davidpalma666/OE-PyBoard-Fork/_aux/pyboard-master from github/images/PYBv10b-photo-back.jpg

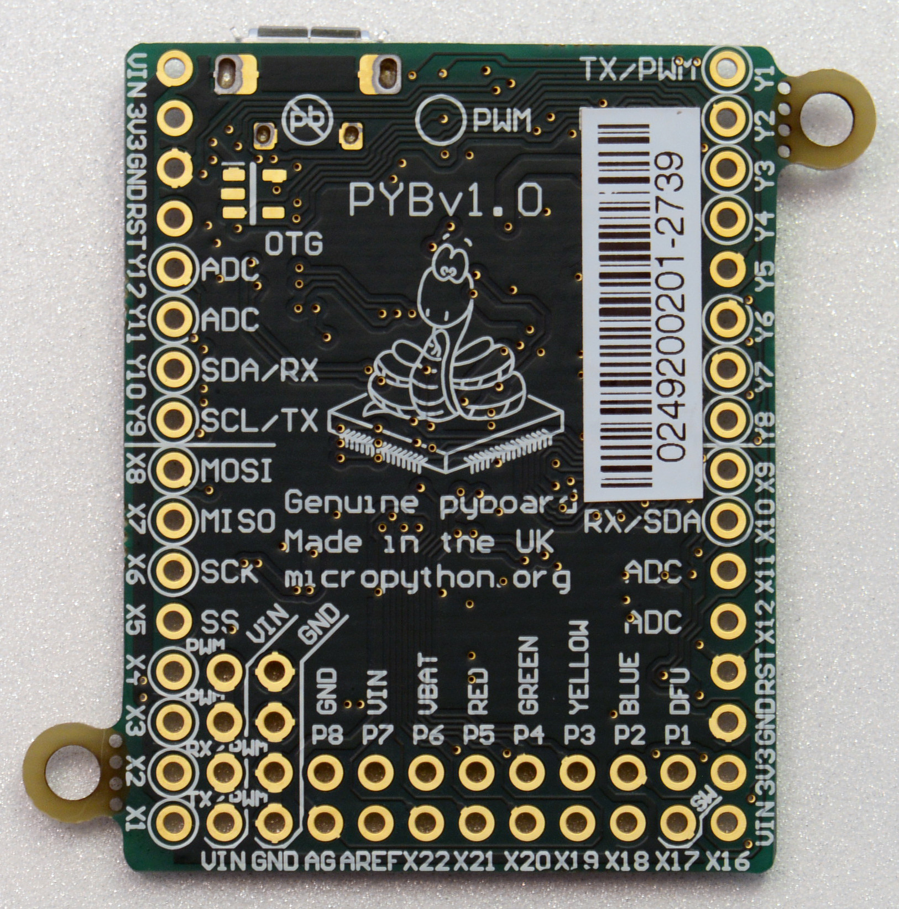
_aux/pyboard-master from github/images/PYBv10b-photo-back.jpg
