davidpalma666/OE-PyBoard-Fork/_aux/pyboard-master from github/images/PYBv10b-photo-front.jpg

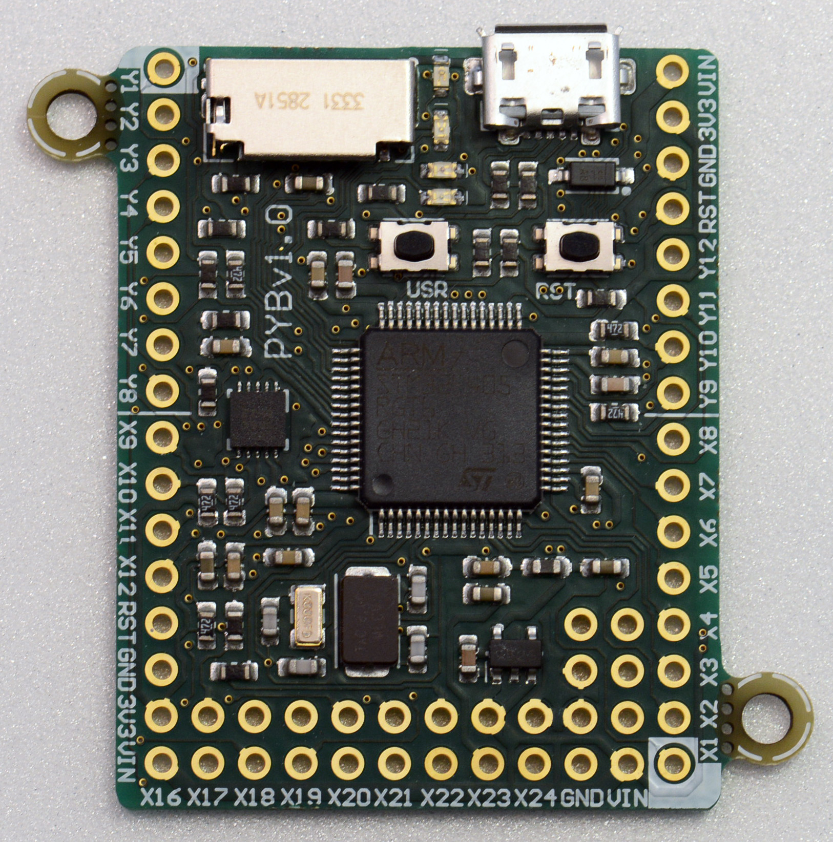
_aux/pyboard-master from github/images/PYBv10b-photo-front.jpg
