davidpalma666/OE-PyBoard-Fork/_aux/pyboard-master from github/images/PYBv10b-render-front.png

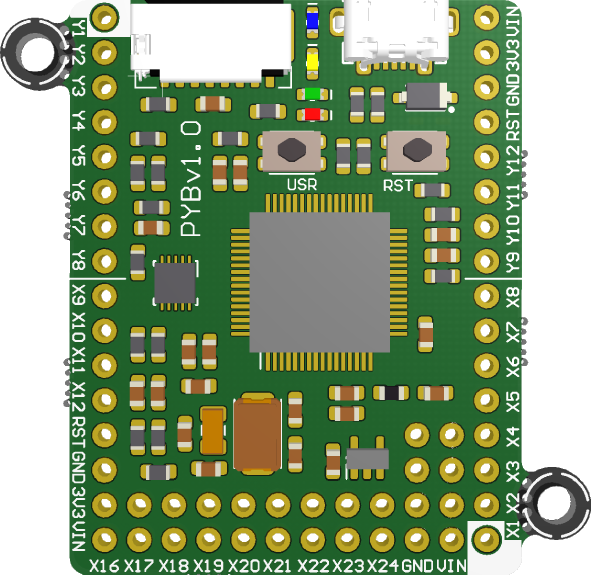
_aux/pyboard-master from github/images/PYBv10b-render-front.png
