davidpalma666/OE-PyBoard-Fork/_aux/pyboard-master from github/pinout/pybv3/pinout.png

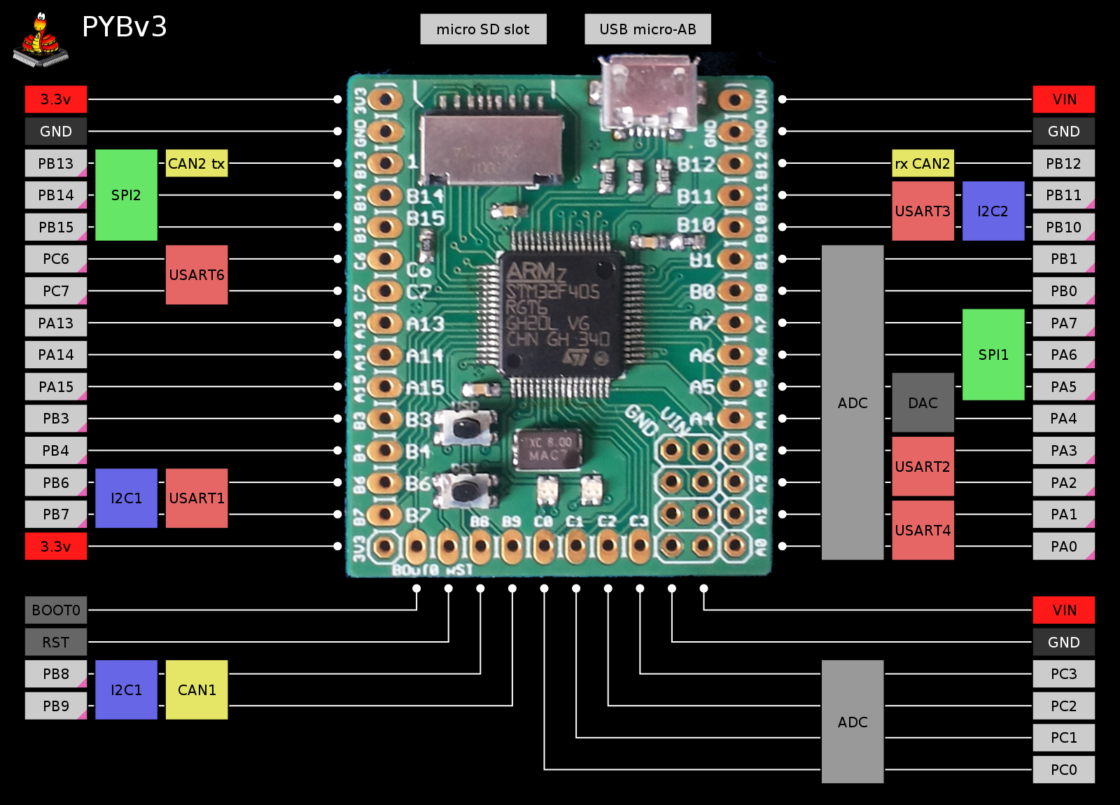
_aux/pyboard-master from github/pinout/pybv3/pinout.png
