davidpalma666/OE-PyBoard-Fork/_aux/pyboard-master from github/pinout/pybv3/pybv3.png

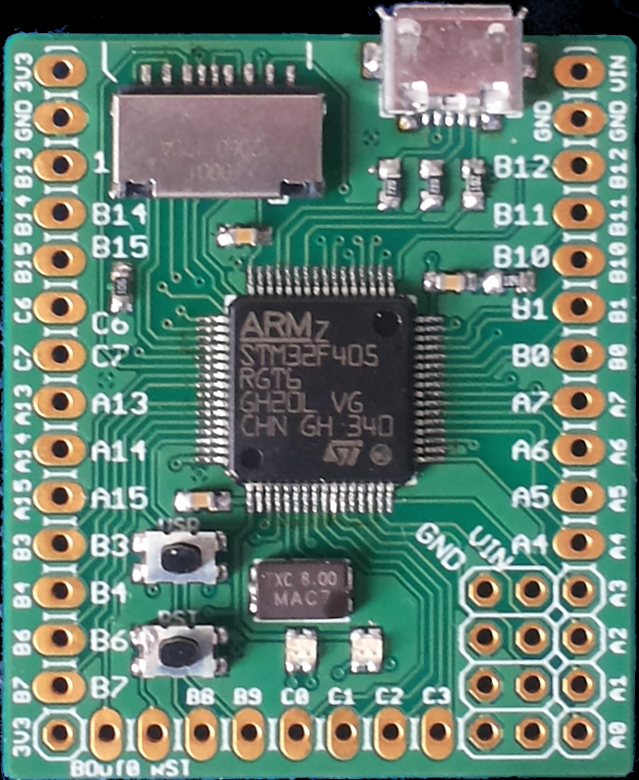
_aux/pyboard-master from github/pinout/pybv3/pybv3.png
