davidpalma666/OE-PyBoard-Fork/_aux/pyboard-master from github/pinout/pybv10b/pinout.png

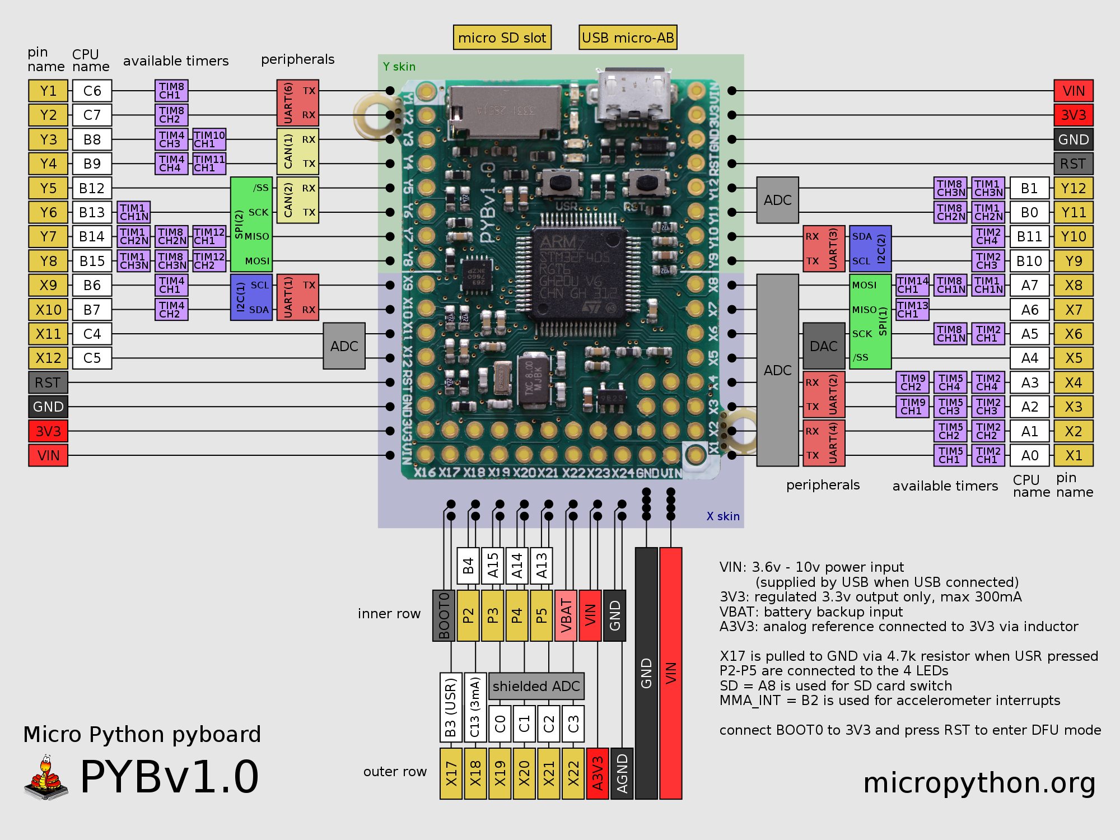
_aux/pyboard-master from github/pinout/pybv10b/pinout.png
