davidpalma666/OE-PyBoard-Fork/_aux/pyboard-master from github/schem.png

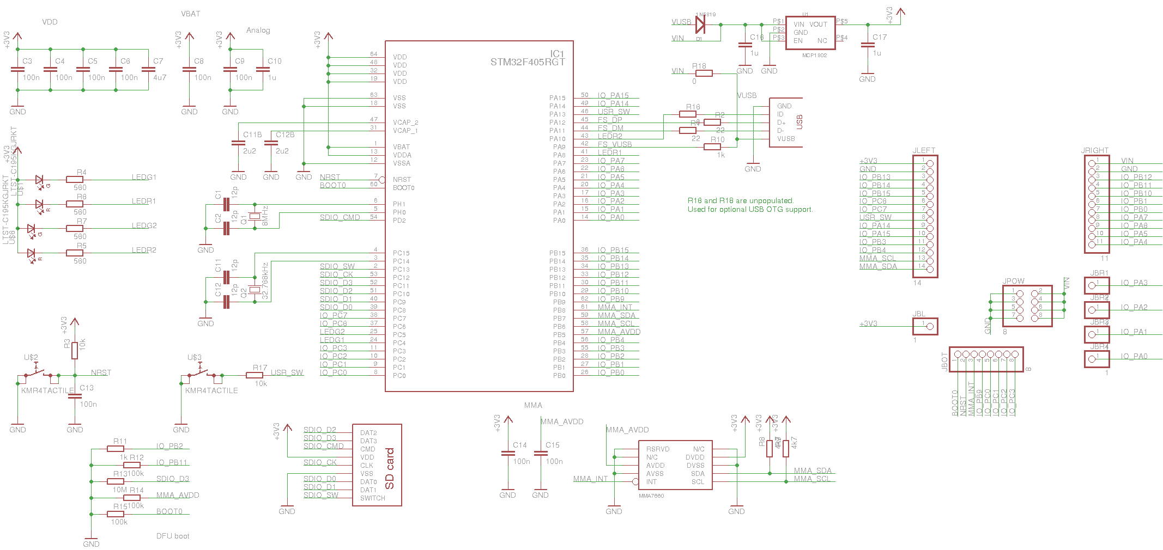
_aux/pyboard-master from github/schem.png
