davidpalma666/OE-PyBoard-Fork/PyBoardTester/pcb/production/PyBoardTester BOM.csv

# | Reference | Qty | Value | Footprint | DNP | MPN | OEPSPN
1 | J1,J2 | 2 | Conn_01x08 | Connector_PinHeader_2.54mm:PinHeader_1x16_P2.54mm_Vertical |  | TSW-116-06-T-S | OEPS070109
2 | ~{RST}#1,~{RST}#2 | 2 | SW_SPST | SWITCH TACTILE SPST-NO 0.05A 12V |  | TL3305BF260QG | OEPS100061
