davidpalma666/OE-PyBoard-Fork/PyBoardTester/pcb/PyBoardTester FootprintLib/SW_SPST_TL3305B.step

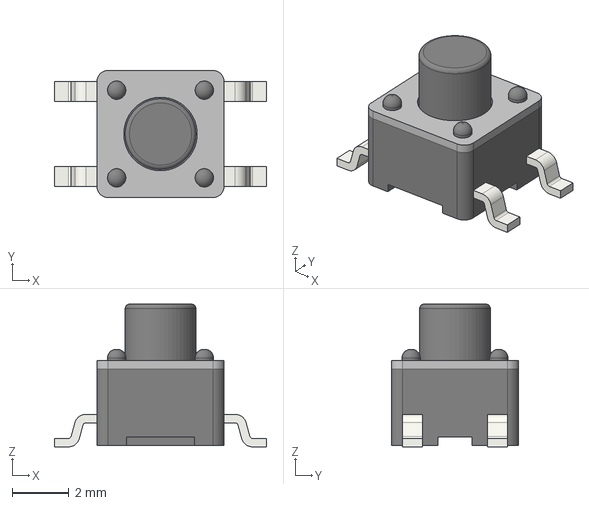
[picture p9: CAD file, 2025-12-09]
PyBoardTester/pcb/PyBoardTester FootprintLib/SW_SPST_TL3305B.step
7.50 x 4.50 x 5.05 mm
