davidpalma666/OE-PyBoard-Fork/PyBoardTester/pcb/PyBoardTester FootprintLib/ECS-.327-12.5-17X-C-TR.step

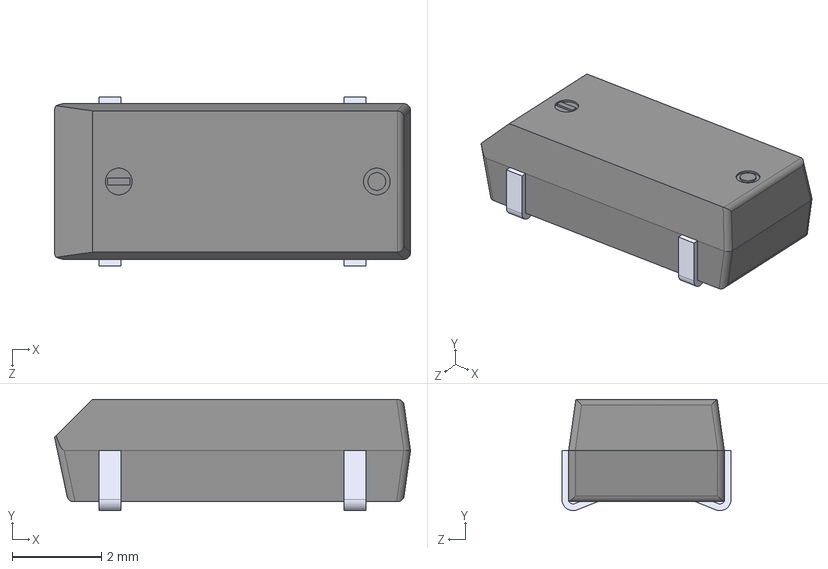
[picture p10: CAD file, 2025-12-09]
PyBoardTester/pcb/PyBoardTester FootprintLib/ECS-.327-12.5-17X-C-TR.step
8.00 x 2.50 x 3.80 mm
