davidpalma666/OE-PyBoard-Fork/PyBoardTester/pcb/PyBoardTester FootprintLib/TSW-116-06-T-S.stp

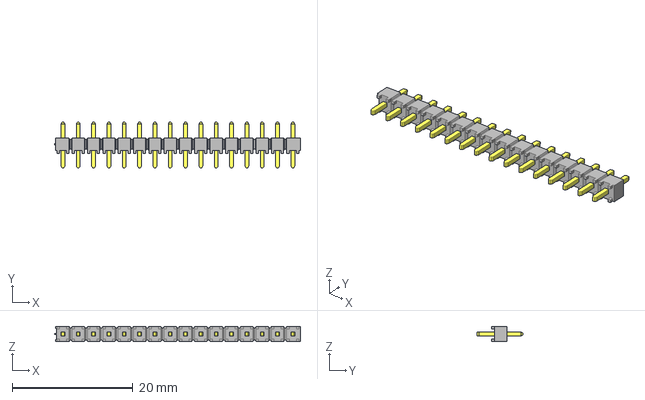
[picture p11: CAD file, 2025-12-09]
PyBoardTester/pcb/PyBoardTester FootprintLib/TSW-116-06-T-S.stp
40.8 x 7.62 x 2.54 mm
TSW-116-06-T-S_body
T-1S6-18-TSW-1-06-16-S
