davidpalma666/OE-PyBoard-Fork/PyBoardTester/pcb/PyBoardTester FootprintLib/475710001.stp

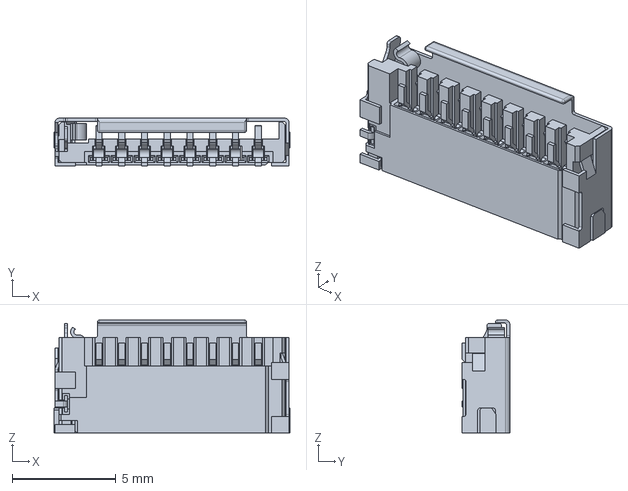
[picture p12: CAD file, 2025-12-09]
PyBoardTester/pcb/PyBoardTester FootprintLib/475710001.stp
11.4 x 2.30 x 5.45 mm
