davidpalma666/OE-PyBoard-Fork/PyBoardTester/pcb/PyBoardTester.kicad_pcb

## KiCad design PyBoardTester/pcb/PyBoardTester.kicad_pcb (2025-12-09)

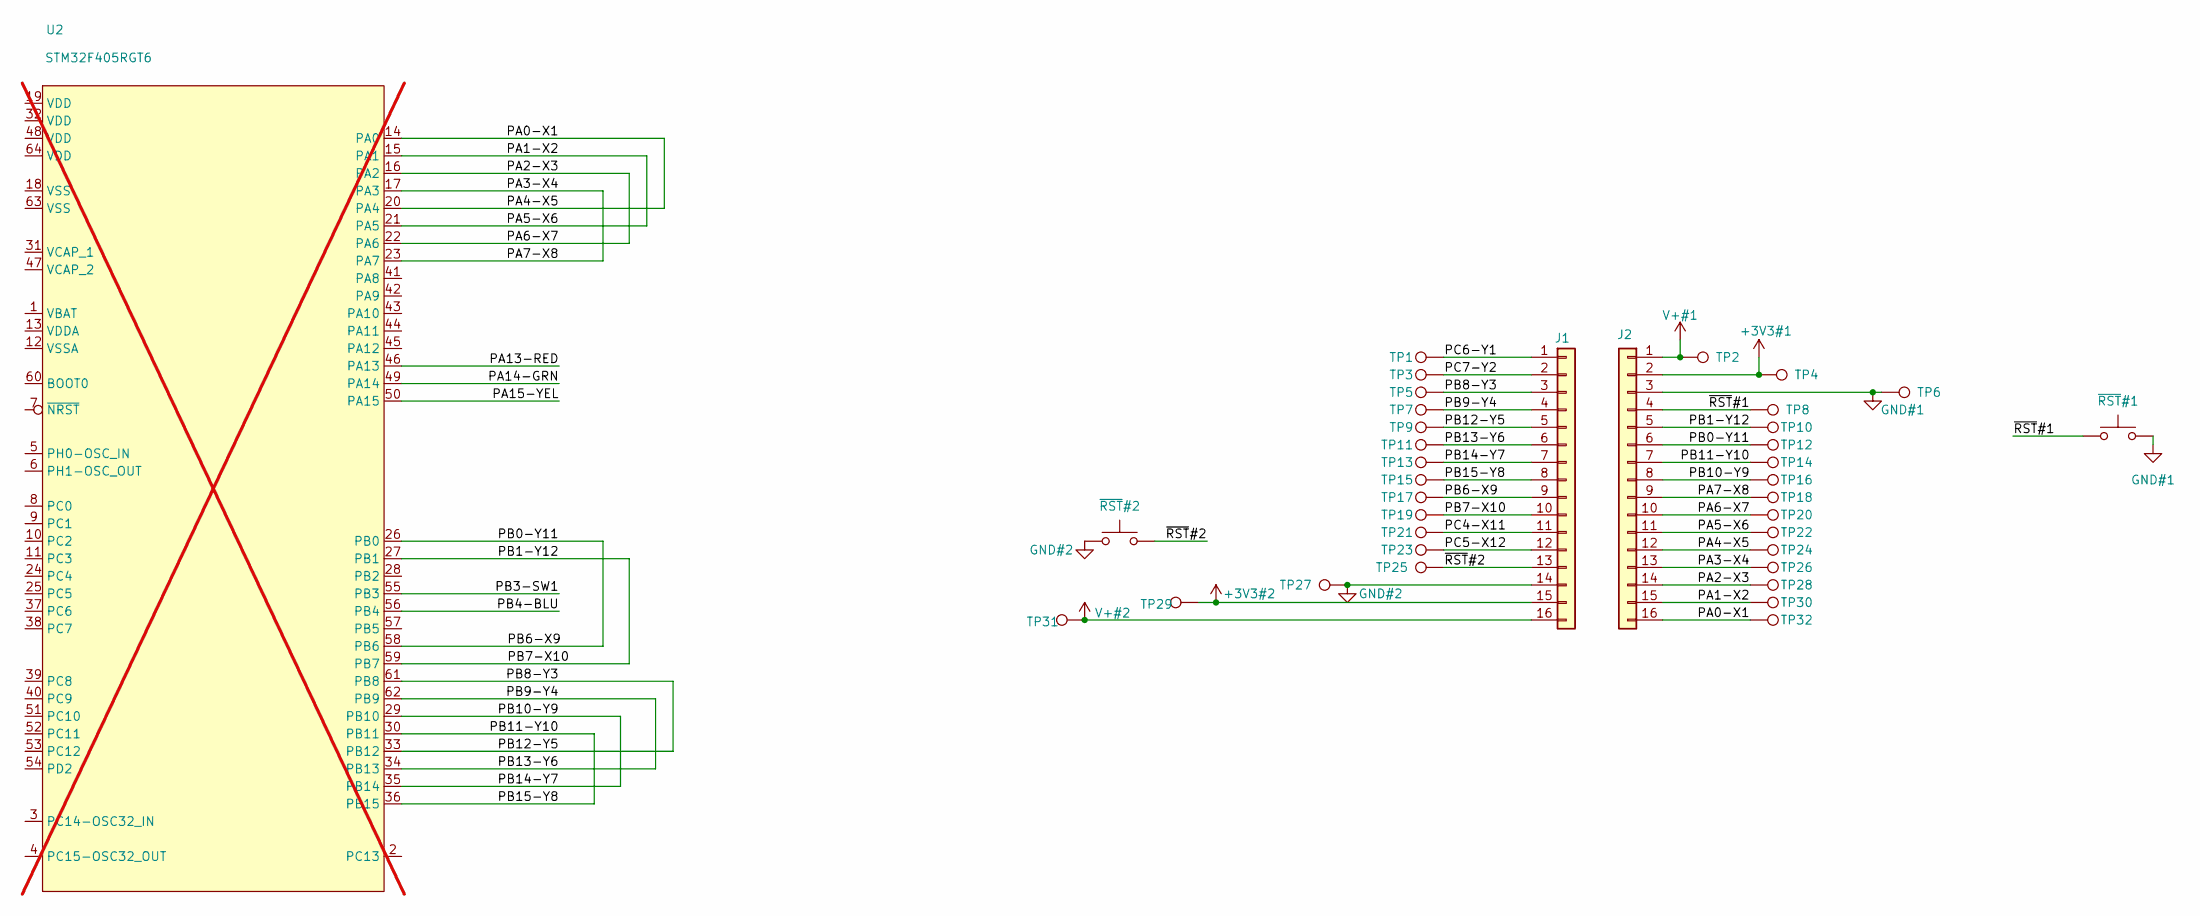
[picture p15: schematic PyBoardTester.kicad_sch]

Parts:
J1, J2: Conn_01x08; PinHeader_1x16_P2.54mm_Vertical; MPN TSW-116-06-T-S
TP1, TP2, TP3, TP4, TP5, TP7, TP8, TP9, TP10, TP11, TP12, TP13, TP14, TP15, TP16, TP17, TP18, TP19, TP20, TP21, TP22, TP23, TP24, TP25, TP26, TP28, TP29, TP30, TP31, TP32: TestPoint; TestPoint_Keystone_5015_Micro_Mini
TP6, TP27: TestPoint; TestPoint_Keystone_5000-5004_Miniature
U2: STM32F405RGT6; LQFP-64_10x10mm_P0.5mm; MPN STM32F405RGT6; not fitted
~{RST}#1, ~{RST}#2: SW_SPST; SWITCH TACTILE SPST-NO 0.05A 12V; MPN TL3305BF260QG

Connections:
+3V3#1: J2.2, TP4.1
+3V3#2: J1.15, TP29.1
/PA0-X1: J2.12, J2.16, TP24.1, TP32.1, U2.14 (PA0), U2.20 (PA4)
/PA1-X2: J2.11, J2.15, TP22.1, TP30.1, U2.15 (PA1), U2.21 (PA5)
/PA2-X3: J2.10, J2.14, TP20.1, TP28.1, U2.16 (PA2), U2.22 (PA6)
/PA3-X4: J2.9, J2.13, TP18.1, TP26.1, U2.17 (PA3), U2.23 (PA7)
/PB0-Y11: J1.9, J2.6, TP12.1, TP17.1, U2.26 (PB0), U2.58 (PB6)
/PB1-Y12: J1.10, J2.5, TP10.1, TP19.1, U2.27 (PB1), U2.59 (PB7)
/PB10-Y9: J1.7, J2.8, TP13.1, TP16.1, U2.29 (PB10), U2.35 (PB14)
/PB11-Y10: J1.8, J2.7, TP14.1, TP15.1, U2.30 (PB11), U2.36 (PB15)
/PB12-Y5: J1.3, J1.5, TP5.1, TP9.1, U2.33 (PB12), U2.61 (PB8)
/PB13-Y6: J1.4, J1.6, TP7.1, TP11.1, U2.34 (PB13), U2.62 (PB9)
/PC4-X11: J1.11, TP21.1
/PC5-X12: J1.12, TP23.1
/PC6-Y1: J1.1, TP1.1
/PC7-Y2: J1.2, TP3.1
/~RST#1: J2.4, TP8.1, ~{RST}#1.1
/~RST#2: J1.13, TP25.1, ~{RST}#2.2
GND#1: J2.3, TP6.1, ~{RST}#1.2
GND#2: J1.14, TP27.1, ~{RST}#2.1
V+#1: J2.1, TP2.1
V+#2: J1.16, TP31.1

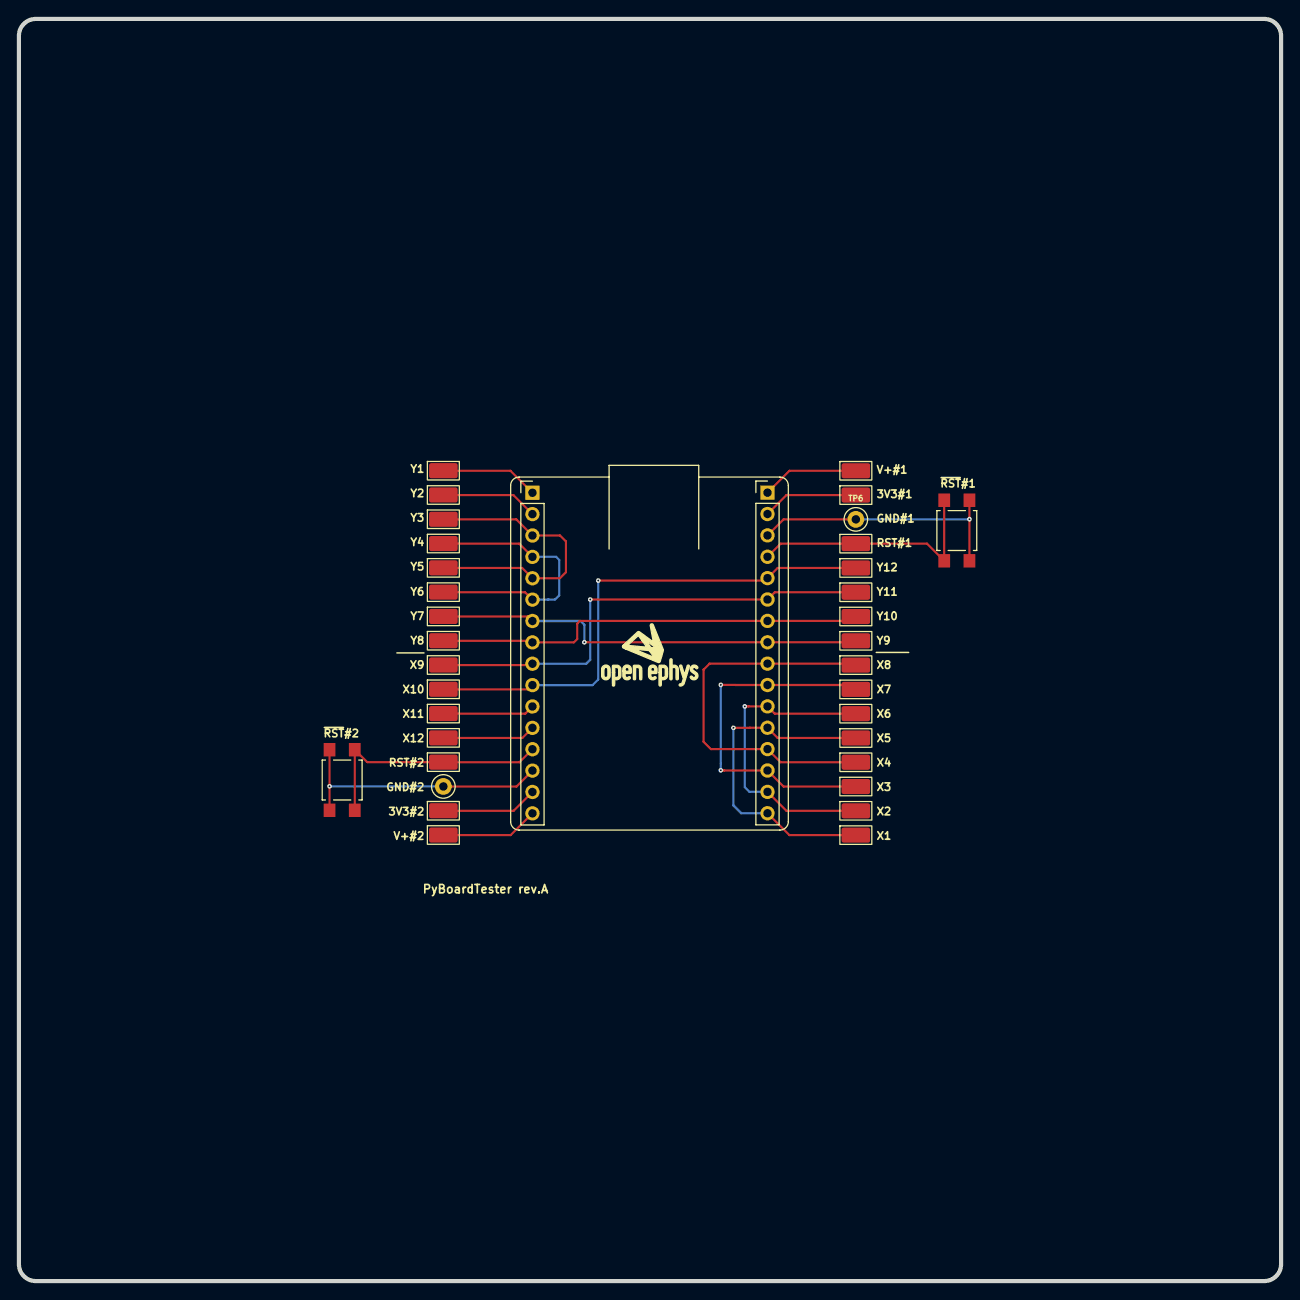
[picture p16: board PyBoardTester.kicad_pcb from above]

Board: 2 copper layers, 150.0 x 150.0 mm, 34 parts (0 on the bottom side), 22 nets.
