davidpalma666/OE-PyBoard-Fork/_aux/PCB v.1.1 1st kicad/PCB 1st kicad/PyBoard 1st Kicad.kicad_pcb

## KiCad design _aux/PCB v.1.1 1st kicad/PCB 1st kicad/PyBoard 1st Kicad.kicad_pcb (2025-10-09)

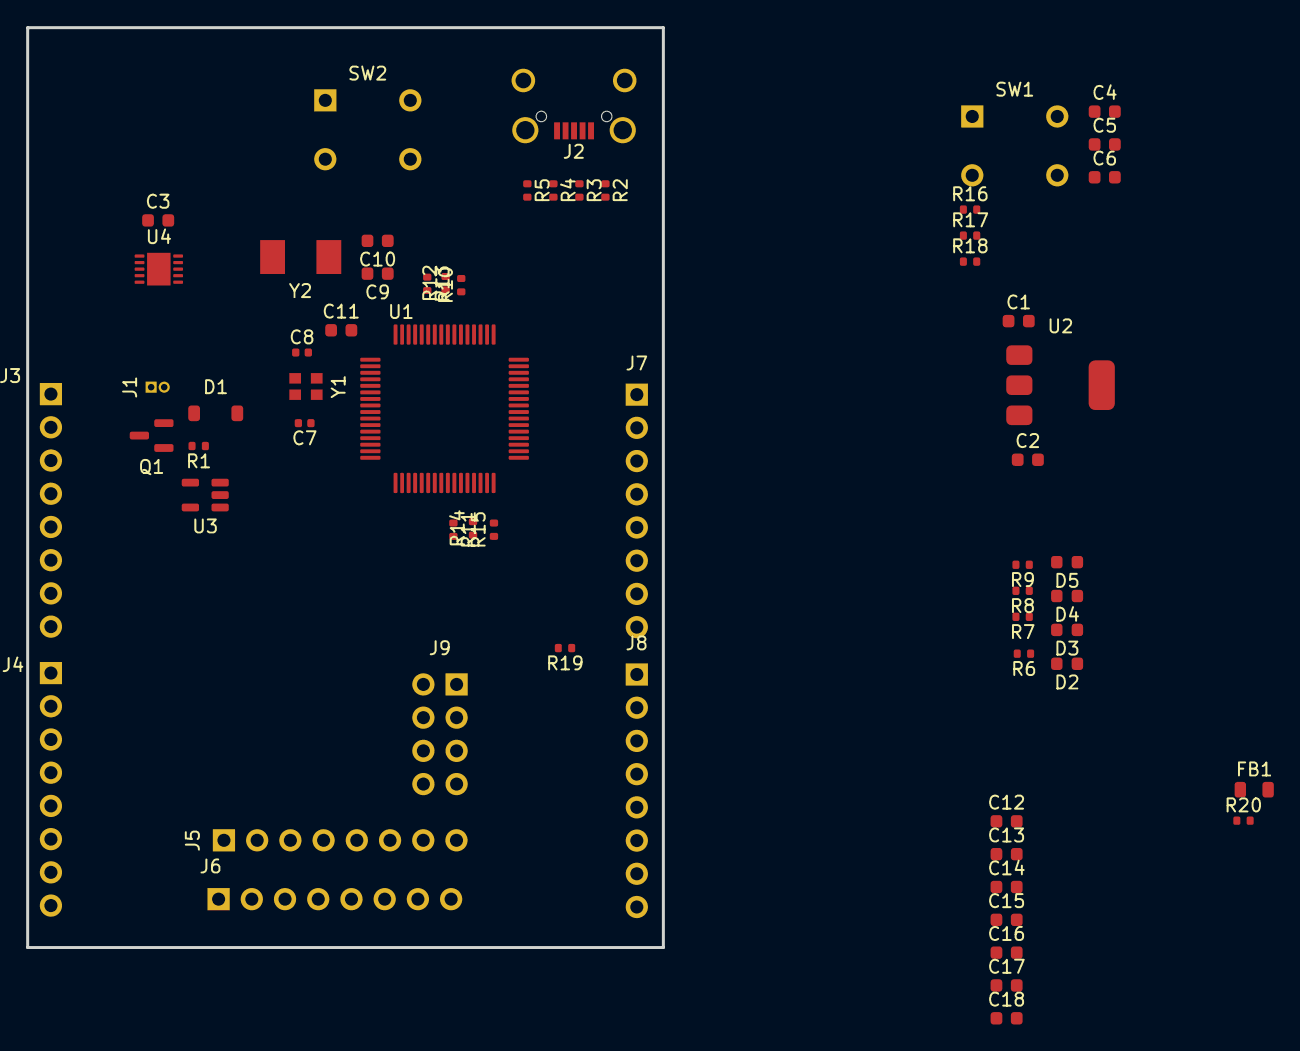
[picture p19: board PyBoard 1st Kicad.kicad_pcb from above]

Board: 2 copper layers, 48.6 x 70.3 mm, 62 parts (0 on the bottom side), 65 nets, no tracks yet.

Parts:
C1, C3, C4, C5: 2u2; C_0603_1608Metric
C2: 4u7; C_0603_1608Metric
C6, C11, C12, C13, C14, C15, C18: 100n; C_0603_1608Metric
C7, C8: 10p; C_0402_1005Metric
C9, C10: 2p2; C_0603_1608Metric
C16, C17: 4.7u; C_0603_1608Metric
D1: MSE1PB-M3/89A; D_SOD-123
D2: LED-RED; LED_0603_1608Metric
D3: LED-GREEN; LED_0603_1608Metric
D4: LED-YELLOW; LED_0603_1608Metric
D5: LED-BLUE; LED_0603_1608Metric
FB1: 1k; L_0805_2012Metric
J1: Conn_01x02; PinHeader_1x02_P1.00mm_Vertical
J2: USB_B_Micro; USB_Micro-B_Wuerth_629105150521_CircularHoles
J3, J4, J5, J6, J7, J8: Conn_01x08; PinHeader_1x08_P2.54mm_Vertical
J9: Conn_02x04_Odd_Even; PinSocket_2x04_P2.54mm_Vertical
Q1: DMP2160UW; SOT-23
R1, R10, R11, R17, R19: 100k; R_0402_1005Metric
R2, R5, R6, R7, R8: 560R; R_0402_1005Metric
R3, R4: 22R; R_0402_1005Metric
R9, R20: 220R; R_0402_1005Metric
R12, R13, R14, R15, R16, R18: 4k7; R_0402_1005Metric
SW1, SW2: SW_MEC_5E; SW_TH_Tactile_Omron_B3F-10xx
U1: STM32F405RGT6; LQFP-64_10x10mm_P0.5mm
U2: MCP1703 3V3; SOT-223-3_TabPin2
U3: MIC2005A-1YM5; SOT-23-5
U4: MMA7660; WDFN-10-1EP_3x3mm_P0.5mm_EP1.8x2.5mm
Y1: Crystal_GND24; Crystal_SMD_Abracon_ABM10-4Pin_2.5x2.0mm
Y2: Crystal; Crystal_SMD_Abracon_ABM7-2Pin_6.0x3.5mm

Connections:
+3V3: C2.1, C12.1, C13.1, C14.1, C15.1, C16.1, FB1.1, J4.7, J7.2, R12.1, R13.1, R14.1, R15.1, R18.1, R19.1, U1.19 (VDD), U1.32 (VDD), U1.48 (VDD), U1.64 (VDD), U2.3 (VO), U4.9 (DVDD)
+5V: C1.1, D1.1 (K), J4.8, J5.7, J7.1, Q1.2 (S), U2.1 (VI), U3.1 (VIN)
/B: D5.2 (A), R9.2, U3.3 (EN)
/BOOT0-P1: J5.1, R17.1, U1.60 (BOOT0/VPP)
/D+: J2.3 (D+), R3.2
/D-: J2.2 (D-), R4.2
/G: D3.2 (A), R7.2
/ID: J2.4 (ID), R5.2
/N1: C9.1, U1.3 (PC14-OSC32_IN(PC14)/EVENTOUT/OSC32_IN), Y2.1
/N2: C10.1, U1.4 (PC15-OSC32_OUT(PC15)/EVENTOUT/OSC32_OUT), Y2.2
/N3: C8.1, U1.5 (PH0-OSC_IN(PH0)/EVENTOUT/OSC_IN), Y1.1
/N4: C7.1, U1.6 (PH1-OSC_OUT(PH1)/EVENTOUT/OSC_OUT), Y1.4
/PA0-X1: J8.8, U1.14 (PA0-WKUP(PA0)/USART2_CTS/UART4_TX/ETH_M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)
/PA1-X2: J8.7, U1.15 (PA1/USART2_RTS/UART4_RX/ETH_RMII_REF_CL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)
/PA2-X3: J8.6, U1.16 (PA2/USART2_TX/TIM5_CH3/TIM9_CH1/TIM2_CH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)
/PA3-X4: J8.5, U1.17 (PA3/USART2_RX/TIM5_CH4/TIM9_CH2/TIM2_CH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)
/PA4-X5: J8.4, U1.20 (PA4/SPI1_NSS/SPI3_NSS/USART2_CK/DCMI_HS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)
/PA5-X6: J8.3, U1.21 (PA5/SPI1_SCK/OTG_HS_ULPI_CK/TIM2_CH1_ET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)
/PA6-X7: J8.2, U1.22 (PA6/SPI1_MISO/TIM8_BKIN/TIM13_CH1/DCMI_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)
/PA7-X8: J8.1, U1.23 (PA7/SPI1_MOSI/TIM8_CH1N/TIM14_CH1/TIM3_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)
/PA9-VBUS: R2.1, U1.42 (PA9/USART1_TX/TIM1_CH2/I2C3_SMBA/DCMI_D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)
/PA10-ID: R5.1, R19.2, U1.43 (PA10/USART1_RX/TIM1_CH3/OTG_FS_ID/DCMI_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)
/PA11-DM: R4.1, U1.44 (PA11/USART1_CTS/CAN1_RX/TIM1_CH4/OTG_FS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)
/PA12-DP: R3.1, U1.45 (PA12/USART1_RTS/CAN1_TX/TIM1_ETR/OTG_FS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)
/PA13-RED-P5: J5.5, R6.1, U1.46 (PA13(JTMS-SWDIO)/JTMS-SWDIO/EVENTOUT)
/PA14-GRN-P4: J5.4, R7.1, U1.49 (PA14(JTCK-SWCLK)/JTCK-SWCLK/EVENTOUT)
/PA15-YEL-P3: J5.3, R8.1, U1.50 (PA15(JTDI)/JTDI/SPI3_NSS/I2S3_WS/TIM2_C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)
/PB0-Y11: J7.6, U1.26 (PB0/TIM3_CH3/TIM8_CH2N/OTG_HS_ULPI_D1/E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)
/PB1-Y12: J7.5, U1.27 (PB1/TIM3_CH4/TIM8_CH3N/OTG_HS_ULPI_D2/E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)
/PB2-BOOT1-MMA-INT: R11.1, U1.28 (PB2-BOOT1(PB2)/EVENTOUT), U4.5 (~INT)
/PB3-SW-X17: J6.1, R16.1, U1.55 (PB3(JTDO/TRACESWO)/JTDO/TRACESWO/SPI3_S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)
/PB4-BLU-P2: J5.2, R9.1, U1.56 (PB4(NJTRST)/NJTRST/SPI3_MISO/TIM3_CH1/S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)
/PB5-MMA_AVDD: C3.1, R10.1, U1.57 (PB5/I2C1_SMBA/CAN2_RX/OTG_HS_ULPI_D7/ET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), U4.3 (AVDD)
/PB6-SCL-X9: J4.1, R12.2, U1.58 (PB6/I2C1_SCL/TIM4_CH1/CAN2_TX/DCMI_D5/U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), U4.6 (SCL)
/PB7-SDA-X10: J4.2, R13.2, U1.59 (PB7/I2C1_SDA/FSMC_NL/DCMI_VSYNC/USART1_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), U4.7 (SDA)
/PB8-Y3: J3.3, U1.61 (PB8/TIM4_CH3/SDIO_D4/TIM10_CH1/DCMI_D6/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)
/PB9-Y4: J3.4, U1.62 (PB9/SPI2_NSS/I2S2_WS/TIM4_CH4/TIM11_CH1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)
/PB10-Y9: J7.8, R14.2, U1.29 (PB10/SPI2_SCK/I2S2_CK/I2C2_SCL/USART3_T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)
/PB11-Y10: J7.7, R15.2, U1.30 (PB11/I2C2_SDA/USART3_RX/OTG_HS_ULPI_D4/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)
/PB12-Y5: J3.5, U1.33 (PB12/SPI2_NSS/I2S2_WS/I2C2_SMBA/USART3_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)
/PB13-Y6: J3.6, U1.34 (PB13/SPI2_SCK/I2S2_CK/USART3_CTS/TIM1_C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)
/PB14-Y7: J3.7, U1.35 (PB14/SPI2_MISO/TIM1_CH2N/TIM12_CH1/OTG_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)
/PB15-Y8: J3.8, U1.36 (PB15/SPI2_MOSI/I2S2_SD/TIM1_CH3N/TIM8_C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)
/PC0-X19: J6.3, U1.8 (PC0/OTG_HS_ULPI_STP/EVENTOUT/ADC123_IN10)
/PC1-X20: J6.4, U1.9 (PC1/ETH_MDC/EVENTOUT/ADC123_IN11)
/PC2-X21: J6.5, U1.10 (PC2/SPI2_MISO/OTG_HS_ULPI_DIR/ETH_MII_T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)
/PC3-X22: J6.6, U1.11 (PC3/SPI2_MOSI/I2S2_SD/OTG_HS_ULPI_NXT/E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)
/PC4-X11: J4.3, U1.24 (PC4/ETH_RMII_RX_D0/ETH_MII_RX_D0/EVENTO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)
/PC5-X12: J4.4, U1.25 (PC5/ETH_RMII_RX_D1/ETH_MII_RX_D1/EVENTO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)
/PC6-Y1: J3.1, U1.37 (PC6/I2S2_MCK/TIM8_CH1/SDIO_D6/USART6_TX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)
/PC7-Y2: J3.2, U1.38 (PC7/I2S3_MCK/TIM8_CH2/SDIO_D7/USART6_RX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)
/PC13-X18: J6.2, U1.2 (PC13/EVENTOUT/RTC_OUT,RTC_TAMP1,RTC_TS)
/R: D2.2 (A), R6.2
/RST#: C6.1, J4.5, J7.4, R18.2, U1.7 (NRST)
/USR-SW: R16.2, SW2.1
/VBUS: D1.2 (A), J2.1 (VBUS), R1.2, R2.2, U3.5 (VOUT)
/VCAP1: C4.1, U1.31 (VCAP_1)
/VCAP2: C5.1, U1.47 (VCAP_2)
/Y: D4.2 (A), R8.2
A3V3: C17.1, C18.1, FB1.2, J6.7, U1.13 (VDDA)
GND: C1.2, C2.2, C3.2, C4.2, C5.2, C6.2, C7.2, C8.2, C9.2, C10.2, C11.2, C12.2, C13.2, C14.2, C15.2, C16.2, C17.2, C18.2, D2.1 (K), D3.1 (K), D4.1 (K), D5.1 (K), J1.2, J2.5 (GND), J2.6 (Shield), J4.6, J5.8, J6.8, J7.3, R10.2, R11.2, R17.2, SW1.2, U1.12 (VSSA), U1.18 (VSS), U1.63 (VSS), U2.2 (GND), U3.2 (GND), U4.1 (RSRVD), U4.2 (N.C.), U4.4 (AVSS), U4.8 (DVSS), U4.10 (RSRVD), Y1.2, Y1.3
unnamed: J5.6, R20.2
unnamed: Q1.1 (G), R1.1
VBACKUP: C11.1, R20.1, U1.1 (VBAT)
VBAT: J1.1, Q1.3 (D)
