davidpalma666/OE-PyBoard-Fork/(commit log)

2025-10-01 rev B - inicio
    [MicroPython.step, PyBoard 1st Kicad.kicad_pcb, PyBoard 1st Kicad.kicad_sch, pyboard.brd, pyboard.sch, stm32f4xx_af.csv]
2025-10-09 . preparada para produção
    - demoninação rev.B passada a rev.A
    - criados ficheiros de produção:
    . Gerbers & Drills
    . IPC-2581
    . OE PyBoard BOM
    [OE PyBoard BOM.csv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]
2025-12-09 re-tunning...
    - tunning from main branch to fork
    - fork already had files & folders that had to be deleted - conflict issues
    - files & folder structure now rebuilt as-it-was on 'my fork', before solving conflict issues:
    . new files about pyBoardTester PCBc
    . _aux folder
    [475710001.stp, ECS-.327-12.5-17X-C-TR.step, PyBoardTester BOM.csv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]
